ianaraphael/Radio-dataloggers/Individual Modules/readPinger/pinger_wiring.jpg

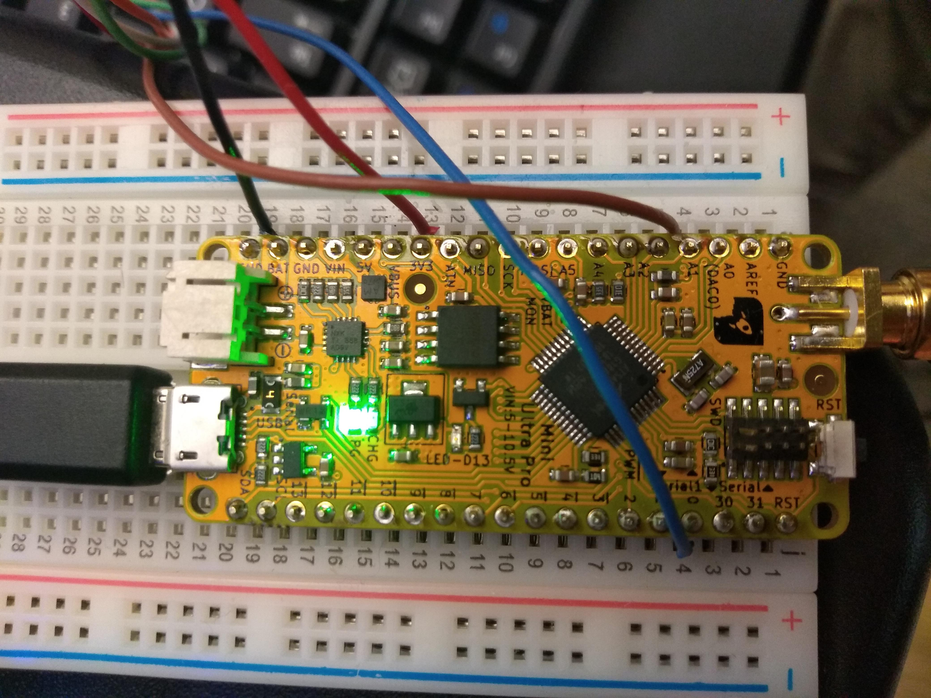
Individual Modules/readPinger/pinger_wiring.jpg
