ianaraphael/Radio-dataloggers/README.md

# SNICE_therm
Snow/ice thermistor dataloggers
