ianaraphael/Radio-dataloggers/Individual Modules/tempSensors/README.md

**Temp Sensors**

*Ian Raphael*
ian.th@dartmouth.edu
2021.07.19

High level functions to initialize an array of temps sensors, read, and save their data.
