ianaraphael/Radio-dataloggers/pingerParts_arcwatchDeployment.xlsx

part | quantity per board | total needed | on hand | to order | price per | total price | link |  | not ordered | clients desired
MCU (rocket scream mini ultra pro v4) | 1 | 10 | 10 | 0 | 40 | 0 | https://www.rocketscream.com/blog/product/mini-ultra-pro-v4-with-radio/ |  | ordered | 10
SD card reader | 1 | 10 | 4 | 6 | 7.5 | 45 | https://www.adafruit.com/product/254 |  | arrived
temp sensors (ds18b20) | 2 | 20 | 0 | 20 |  | 0 |  | Have Mike's sensors for deployment, use the money to test a bunch of new sensors on the market
snow pinger (MB7380-201) | 1 | 10 |  | 10 |  | 0 |  | Maybe some at CRREL, some up at Fairbanks (7541…? Chris will check model number. Std. horn)
10K resistors | 2 | 20 |  | 20 |  | 0
4.7K resistors | 1 | 10 |  | 10 |  | 0
PCB | 1 | 10 |  | 10 |  | 0
6x1 screw terminal | 1 | 10 |  | 10 |  | 0
3x1 screw terminal | 1 | 10 |  | 10 |  | 0
Antennas | 1 | 10 | 10 | 0 |  | 0 |  | CRREL?
Project box | 1 | 10 | 2 | 8 | 9.95 | 79.6 | https://www.adafruit.com/product/3931
Cable glands | 1 | 10 | 0 | 10 |  | 0
Cable gland gasket | 1 | 10 |  | 10 |  | 0
Battery | 1 | 10 |  | 10 |  | 0 |  | ni chem batteries that work well in the cold?
Memory card | 1 | 10 | 10 | 0 |  | 0
 |  | 0 |  | 0 |  | 0
 |  | 0 |  | 0 |  | 0
 |  | 0 |  | 0 |  | 0
