ianaraphael/Radio-dataloggers/PCBs/V2/tempLogger_clientPCB_2xBattHolder/tempLogger_clientPCB_2xBattHolder.kicad_pcb

## KiCad design PCBs/V2/tempLogger_clientPCB_2xBattHolder/tempLogger_clientPCB_2xBattHolder.kicad_pcb (2024-01-21)

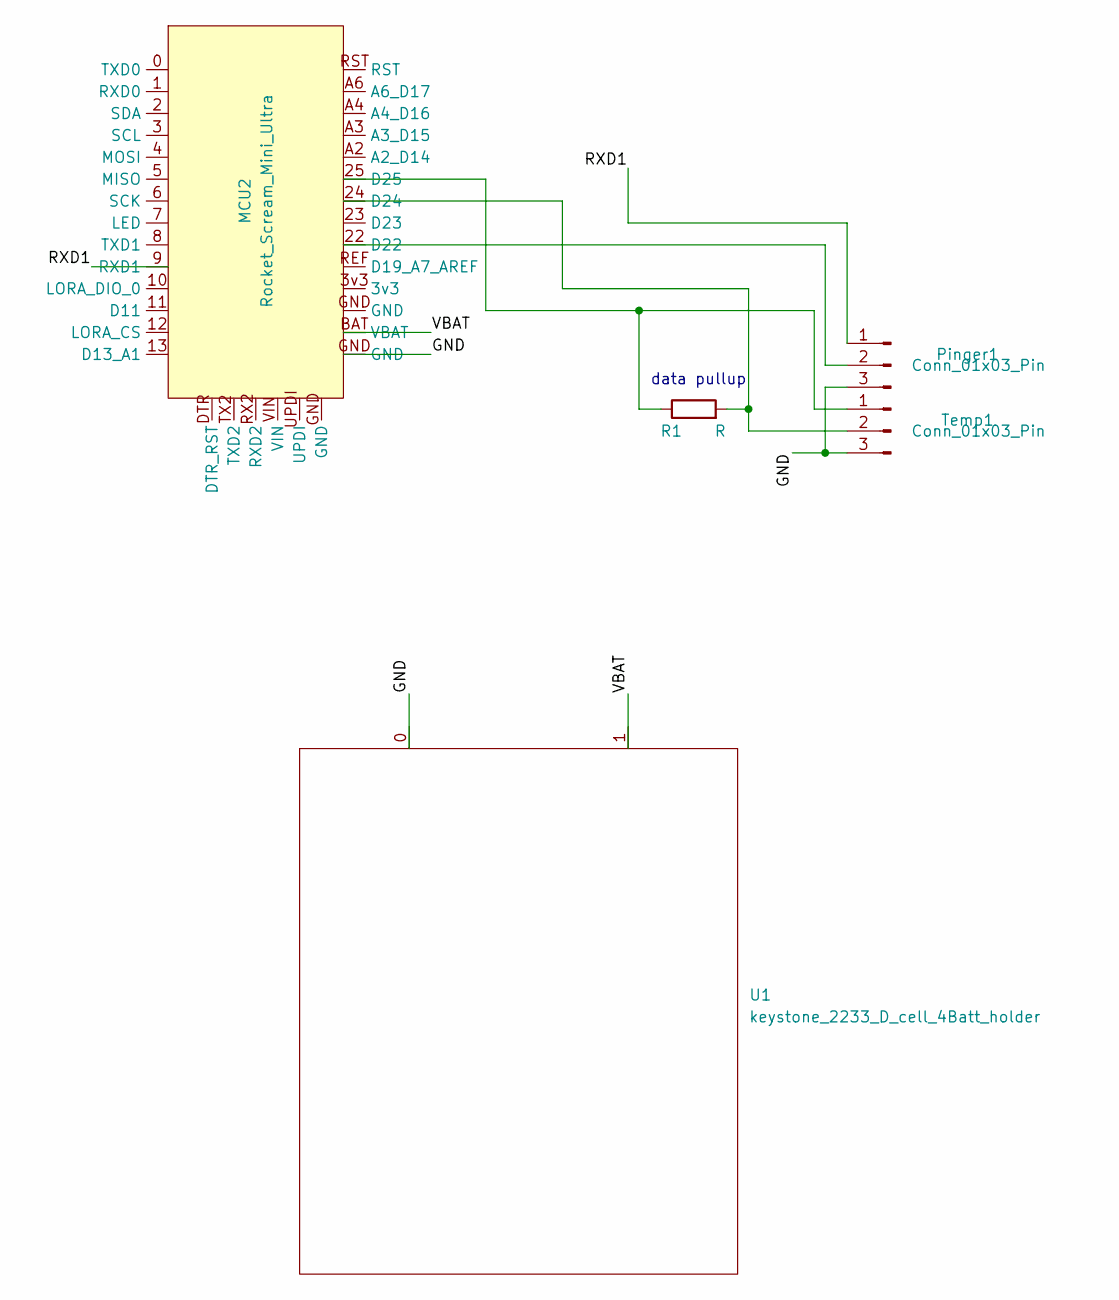
[picture p2: schematic tempLogger_clientPCB_2xBattHolder.kicad_sch]

Parts:
MCU2: Rocket_Scream_Mini_Ultra
Pinger1: Conn_01x03_Pin; Molex_KK-254_AE-6410-03A_1x03_P2.54mm_Vertical
R1: R; R_Axial_DIN0204_L3.6mm_D1.6mm_P7.62mm_Horizontal
Temp1: Conn_01x03_Pin; Molex_KK-254_AE-6410-03A_1x03_P2.54mm_Vertical
U1: keystone_2233_D_cell_4Batt_holder; BatteryHolder_Keystone_2233_4Cell

Connections:
/GND: MCU2.GND, Pinger1.3, Temp1.3, U1.0
/RXD1: MCU2.9 (RXD1), Pinger1.1
/VBAT: MCU2.BAT (VBAT), U1.1
unnamed: MCU2.22 (D22), Pinger1.2
unnamed: MCU2.24 (D24), R1.2, Temp1.2
unnamed: MCU2.25 (D25), R1.1, Temp1.1

Notes on the sheet:
data pullup

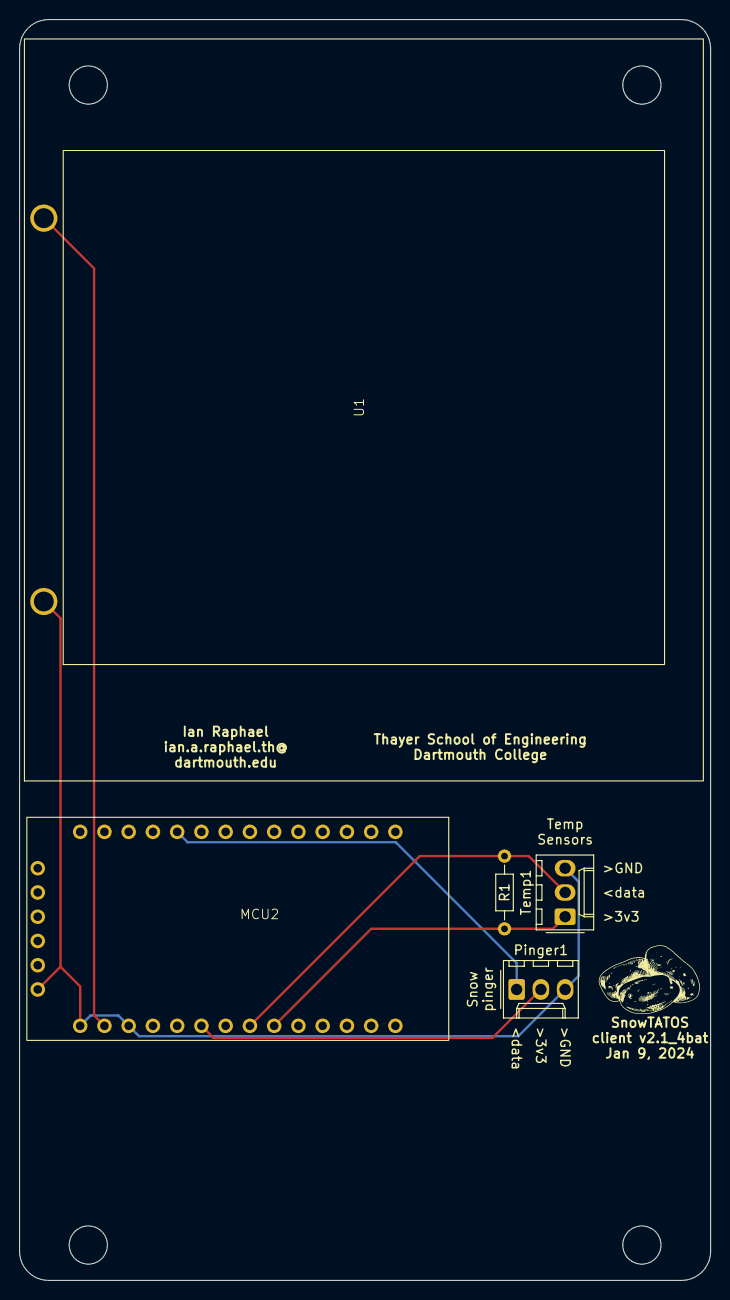
[picture p3: board tempLogger_clientPCB_2xBattHolder.kicad_pcb from above]

Board: 2 copper layers, 72.4 x 132.1 mm, 5 parts (0 on the bottom side), 6 nets.
