ianaraphael/Radio-dataloggers/PCBs/V2/serverPCB/serverPCB.kicad_pcb

## KiCad design PCBs/V2/serverPCB/serverPCB.kicad_pcb (2024-01-21)

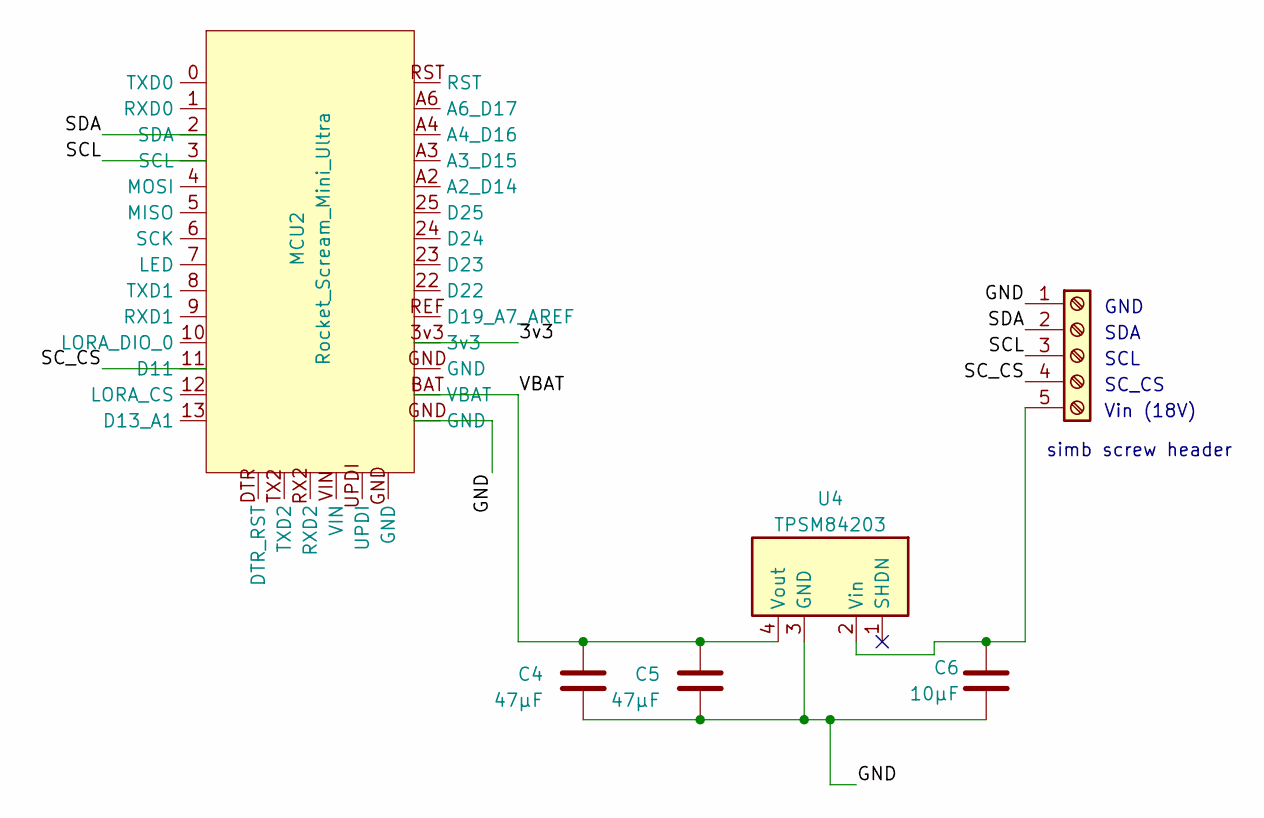
[picture p4: schematic serverPCB.kicad_sch]

Parts:
C4, C5: 47µF; CP_Radial_Tantal_D4.5mm_P2.50mm
C6: 10µF; CP_Radial_Tantal_D4.5mm_P2.50mm
J2: Screw_Terminal_01x04; TerminalBlock_Phoenix_MPT-0,5-5-2.54_1x05_P2.54mm_Horizontal
MCU2: Rocket_Scream_Mini_Ultra
U4: TPSM84203; Pololu_D24V5F9

Connections:
/3v3: MCU2.3v3
/GND: C4.2, C5.2, C6.2, J2.1, MCU2.GND, U4.3 (GND)
/SCL: J2.3, MCU2.3 (SCL)
/SC_CS: J2.4, MCU2.11 (D11)
/SDA: J2.2, MCU2.2 (SDA)
/VBAT: C4.1, C5.1, MCU2.BAT (VBAT), U4.4 (Vout)
unnamed: C6.1, J2.5, U4.2 (Vin)

Notes on the sheet:
simb screw header
SCL
SC_CS
SDA
Vin (18V)
GND

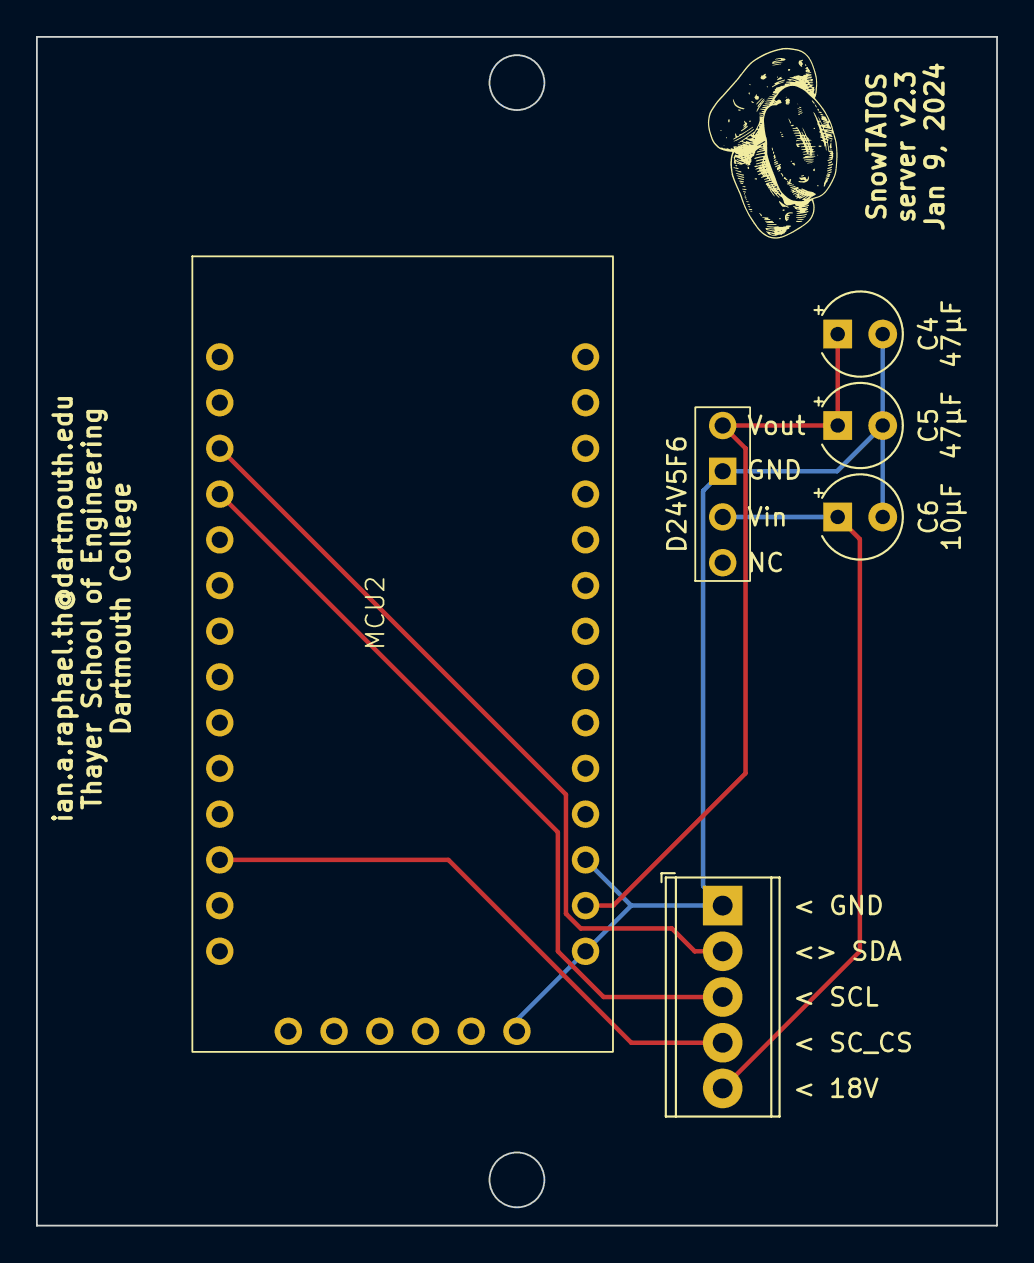
[picture p5: board PCBs/V2/serverPCB/serverPCB.kicad_pcb from above]

Board: 2 copper layers, 53.3 x 66.0 mm, 6 parts (0 on the bottom side), 6 nets.
