ianaraphael/Radio-dataloggers/PCBs/V1/tempLogger_clientPCB/tempLogger_clientPCB.kicad_pcb

## KiCad design PCBs/V1/tempLogger_clientPCB/tempLogger_clientPCB.kicad_pcb (2023-05-18, an earlier design)

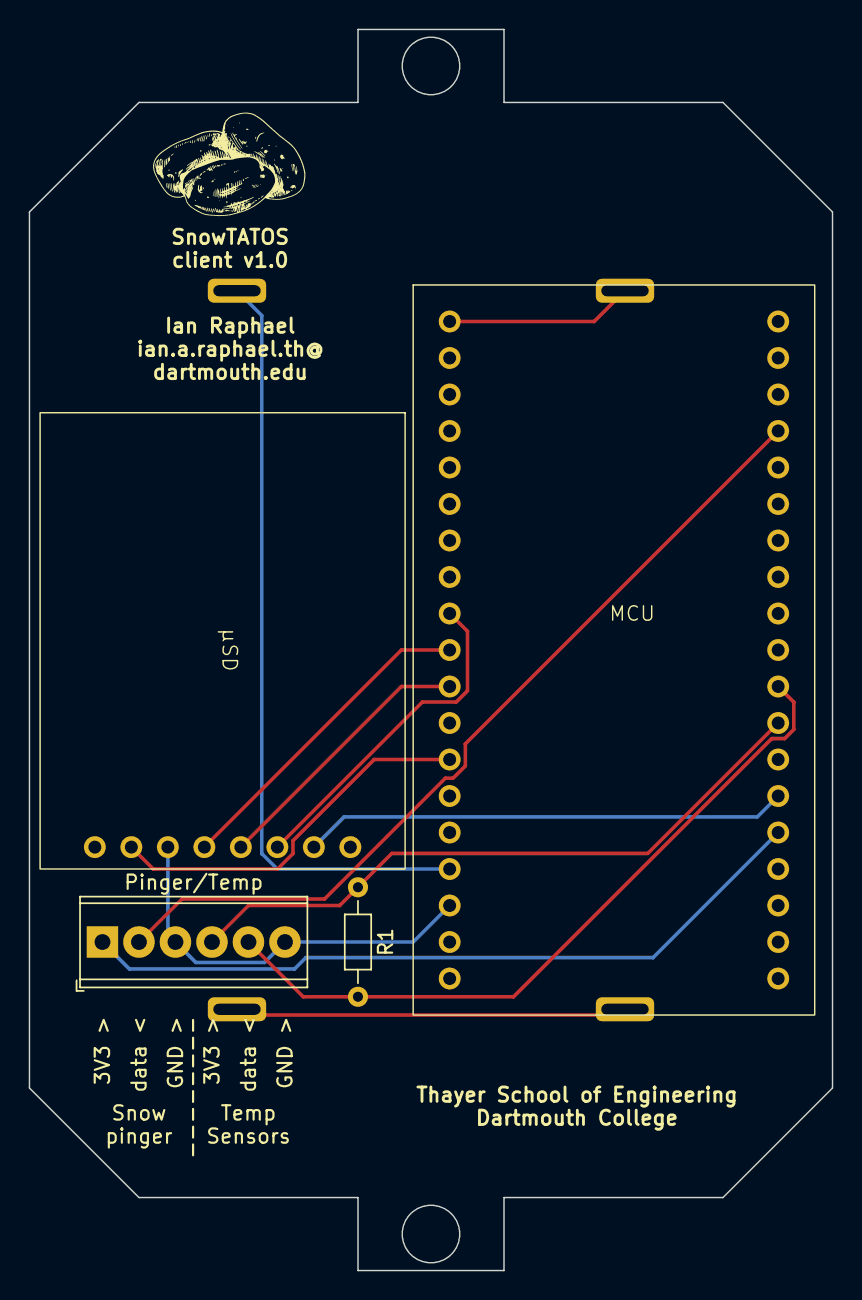
[picture p6: board tempLogger_clientPCB.kicad_pcb from above]

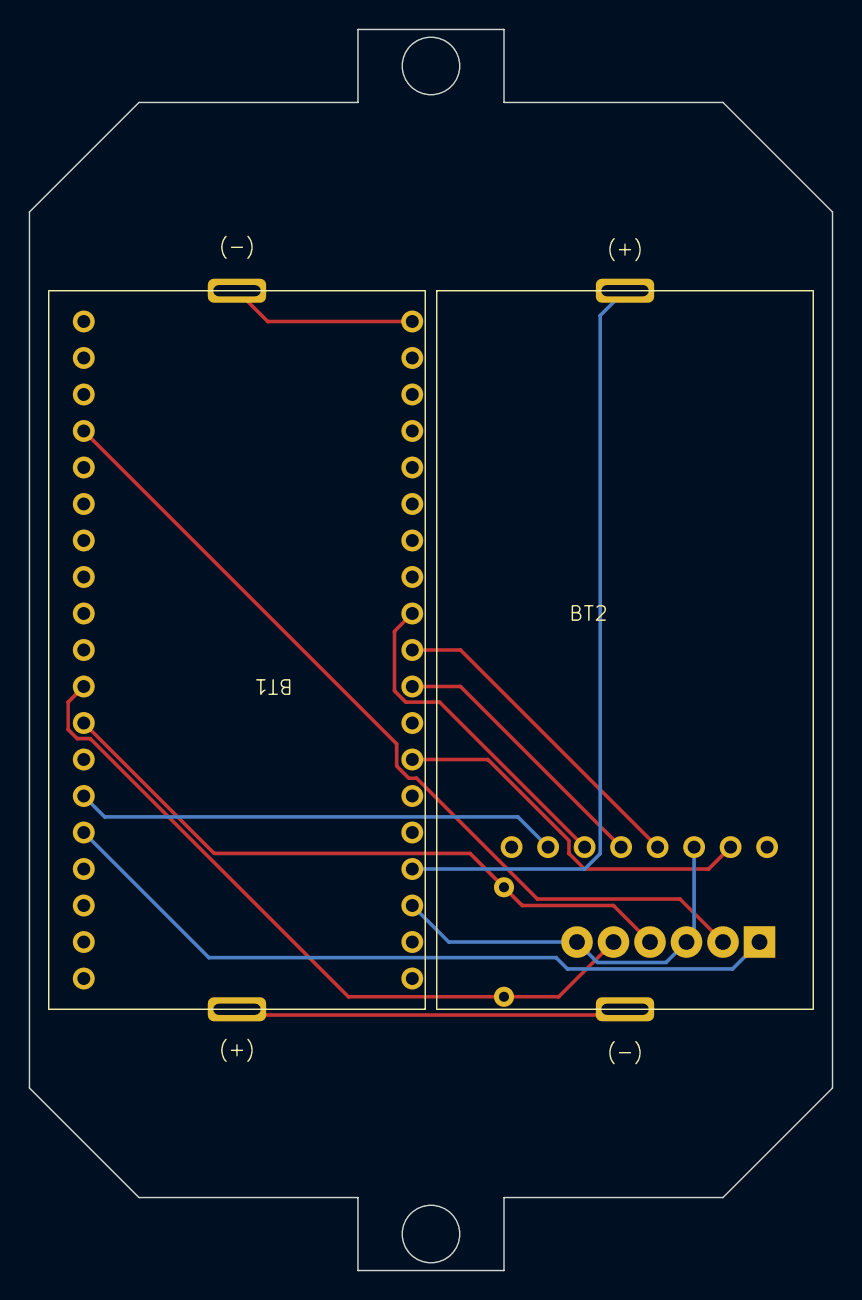
[picture p7: board tempLogger_clientPCB.kicad_pcb from below]

Board: 2 copper layers, 55.9 x 86.4 mm, 6 parts (2 on the bottom side), 12 nets.

Parts:
BT1, BT2: 3.6V; battery_c_cell_solderTabs
MCU: Rocket_Scream_Mini_Ultra_Pro
Pinger/Temp: Screw_Terminal_01x06; TerminalBlock_Phoenix_MPT-0,5-6-2.54_1x06_P2.54mm_Horizontal
R1: R; R_Axial_DIN0204_L3.6mm_D1.6mm_P7.62mm_Horizontal
µSD: micro_sd_cardReader_adafruit

Connections:
/3V3: MCU.3V3, µSD.7 (3V3)
/GND: BT1.2 (-), MCU.GND, Pinger/Temp.3, Pinger/Temp.6, µSD.6 (GND)
/sd_cs: MCU.10 (D10), µSD.2 (CS)
unnamed: BT1.1 (+), BT2.2 (-)
unnamed: BT2.1 (+), MCU.VIN
unnamed: MCU.7 (D7), Pinger/Temp.5, R1.2
unnamed: MCU.8 (D8), Pinger/Temp.4, R1.1
unnamed: MCU.11 (D11), Pinger/Temp.1
unnamed: MCU.22 (MISO), µSD.4 (DO)
unnamed: MCU.23 (MOSI), µSD.3 (DI)
unnamed: MCU.24 (SCK), µSD.5 (CLK)
unnamed: MCU.0 (SERIAL1_RX), Pinger/Temp.2
