ianaraphael/Radio-dataloggers/PCBs/V1/serverPCB/serverPCB.kicad_pcb

## KiCad design PCBs/V1/serverPCB/serverPCB.kicad_pcb (2023-05-18, an earlier design)

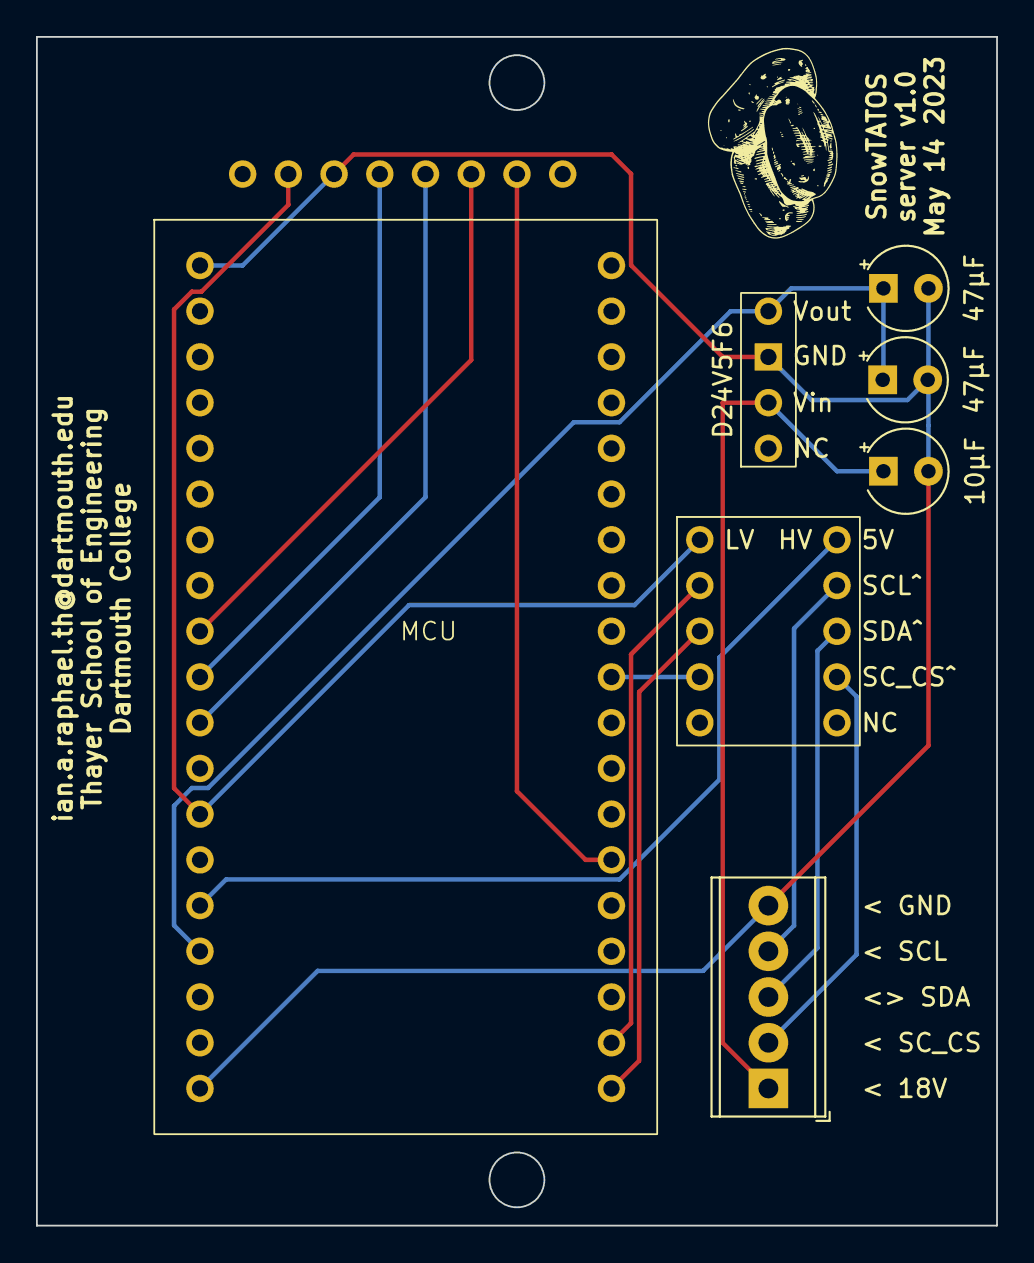
[picture p8: board PCBs/V1/serverPCB/serverPCB.kicad_pcb from above]

Board: 2 copper layers, 53.3 x 66.0 mm, 8 parts (1 on the bottom side), 15 nets.

Parts:
C1: 10µF; CP_Radial_Tantal_D4.5mm_P2.50mm
C2, C3: 47µF; CP_Radial_Tantal_D4.5mm_P2.50mm
J1: Screw_Terminal_01x04; TerminalBlock_Phoenix_MPT-0,5-5-2.54_1x05_P2.54mm_Horizontal
MCU: Rocket_Scream_Mini_Ultra_Pro
U1: TPSM84203; Pololu_D24V5F9
U2: Pololu_logicLevelShifter
µSD: micro_sd_cardReader_adafruit

Connections:
/3V3: MCU.3V3, U2.1 (LV), µSD.7 (3V3)
/5V: MCU.5V, U2.6 (HV)
/GND: C1.2, C2.2, C3.2, J1.5, MCU.GND, U1.3 (GND), µSD.6 (GND)
/sd_cs: MCU.10 (D10), µSD.2 (CS)
unnamed: C1.1, J1.1, U1.2 (Vin)
unnamed: J1.2, U2.9 (H3)
unnamed: J1.3, U2.8 (H2)
unnamed: J1.4, U2.7 (H1)
unnamed: MCU.6 (D6), U2.4 (L3)
unnamed: MCU.22 (MISO), µSD.4 (DO)
unnamed: MCU.23 (MOSI), µSD.3 (DI)
unnamed: MCU.24 (SCK), µSD.5 (CLK)
unnamed: MCU.21 (SCL), U2.2 (L1)
unnamed: MCU.20 (SDA), U2.3 (L2)
unnamed: C2.1, C3.1, MCU.VIN, U1.4 (Vout)
