ianaraphael/Radio-dataloggers/(commit log)

2021-07-12 first readthrough of Pat's code. Some small errors caught.
    [rs_proto_20.ino, rs_proto_21.ino]
2021-07-12 Adding pseudo code for the temp loggers + copying over pat's code to provide framework for v1.
2021-07-19 Reading snow pinger digital output and error checking the string.
    [readPinger.ino]
2021-07-30 temp sensor class for reading and packaging data
2021-07-30 Finished functionality for initing and reading a temp sensors class object
2021-09-03 running with functionality errors
    [server.ino]
2022-08-09 strange behavior between client and server. unexpected new failure to ack
    [client_tempSensors_sleepAlarm.ino, readWrie.ino, server_simple.ino]
2022-10-14 random anti-collision delay working.
    [client_tempSensors_sleepAlarm.ino, client_working.ino]
2022-10-16 fixed rollover on client's interpretation of server file length. deep sleep working.
    [client_working.ino, server_simple.ino]
2022-11-30 client code as deployed in Utqiagvik, November 2022. Wake timer manually set to 1hr.
2023-03-23 PCB dev mostly
    [byteTransfer.xlsx, pingerParts_arcwatchDeployment.xlsx, sensorController_dataSize.xlsx, serverPCB.kicad_pcb, serverPCB.kicad_sch, tempLogger_clientPCB.kicad_pcb, tempLogger_clientPCB.kicad_sch]
2023-03-27 library dev for temp sensors, snow pingers, file handling, radio
2023-04-04 i2c dev
    [pingerParts_arcwatchDeployment.xlsx]
2023-04-05 working with interrupts
    [serverPCB.kicad_pcb, serverPCB.kicad_sch]
2023-05-03 mostly pcb updates. beginning of arcwatch deployment code. updates to libs
    [tempLogger_clientPCB-B_Cu.gbr, tempLogger_clientPCB-B_Mask.gbr, tempLogger_clientPCB-B_Paste.gbr, tempLogger_clientPCB-B_Silkscreen.gbr, tempLogger_clientPCB-Edge_Cuts.gbr, tempLogger_clientPCB-F_Cu.gbr, tempLogger_clientPCB-F_Mask.gbr, tempLogger_clientPCB-F_Paste.gbr]
2023-05-04 integrating i2c comms to server
2023-05-10 i2c comms ready for simb test
2023-05-10 fixing serial/serial usb calls
    [tempController_sensorController_arcwatchTest.ino]
2023-05-18 pcb edits
    [serverPCB.kicad_pcb, serverPCB.kicad_sch, tempLogger_clientPCB.kicad_pcb, tempLogger_clientPCB.kicad_sch]
2023-06-19 compiling and functioning, bug with packing/unpacking client temps
    [client_ArcWatch_v1.ino, tempController_sensorController_arcwatchTest.ino]
2023-11-28 v2 pcbs
    [serverPCB.kicad_pcb, serverPCB.kicad_sch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]
2023-12-18 fully updated but untested server/node code for new mini ultra boards
    [serverPCB.kicad_pcb, serverPCB.kicad_sch]
2023-12-20 successful server integration into barebones simb program and full simb suite with dummy buffer
    [serverPCB.kicad_pcb, serverPCB.kicad_sch]
2024-01-03 implemented full mm resolution for pingers, + voltage monitoring
2024-01-09 fixed packetIndex ISR bug in TC code. added state 0.
    [tempLogger_clientPCB.kicad_sch]
2024-01-21 fixed pinger read error
    [serverPCB.kicad_pcb, serverPCB.kicad_sch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]
